decker502/arducuber/assets/6575.png

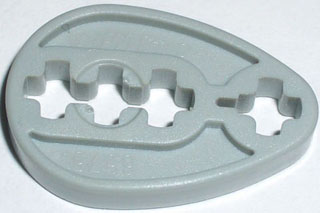
assets/6575.png
