decker502/arducuber/assets/18654.png

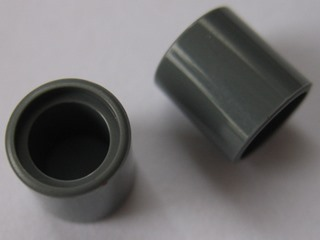
assets/18654.png
