decker502/arducuber/assets/22961.png

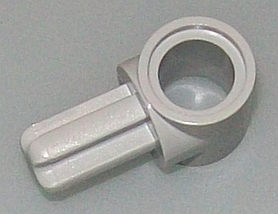
assets/22961.png
