decker502/arducuber/assets/60483.png

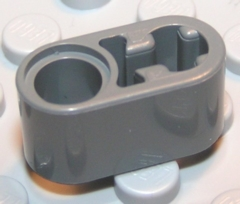
assets/60483.png
