decker502/arducuber/assets/tcs34725.png

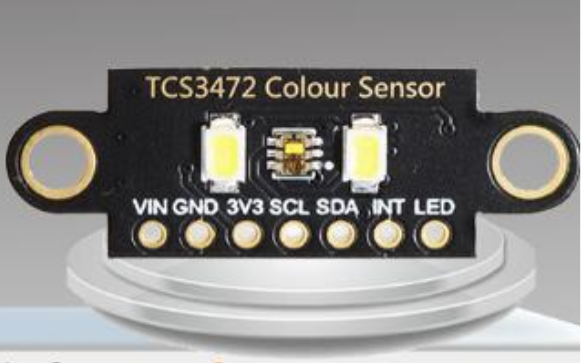
assets/tcs34725.png
