decker502/arducuber/kit/bricktronics_megashield-schematic-v1.01.png

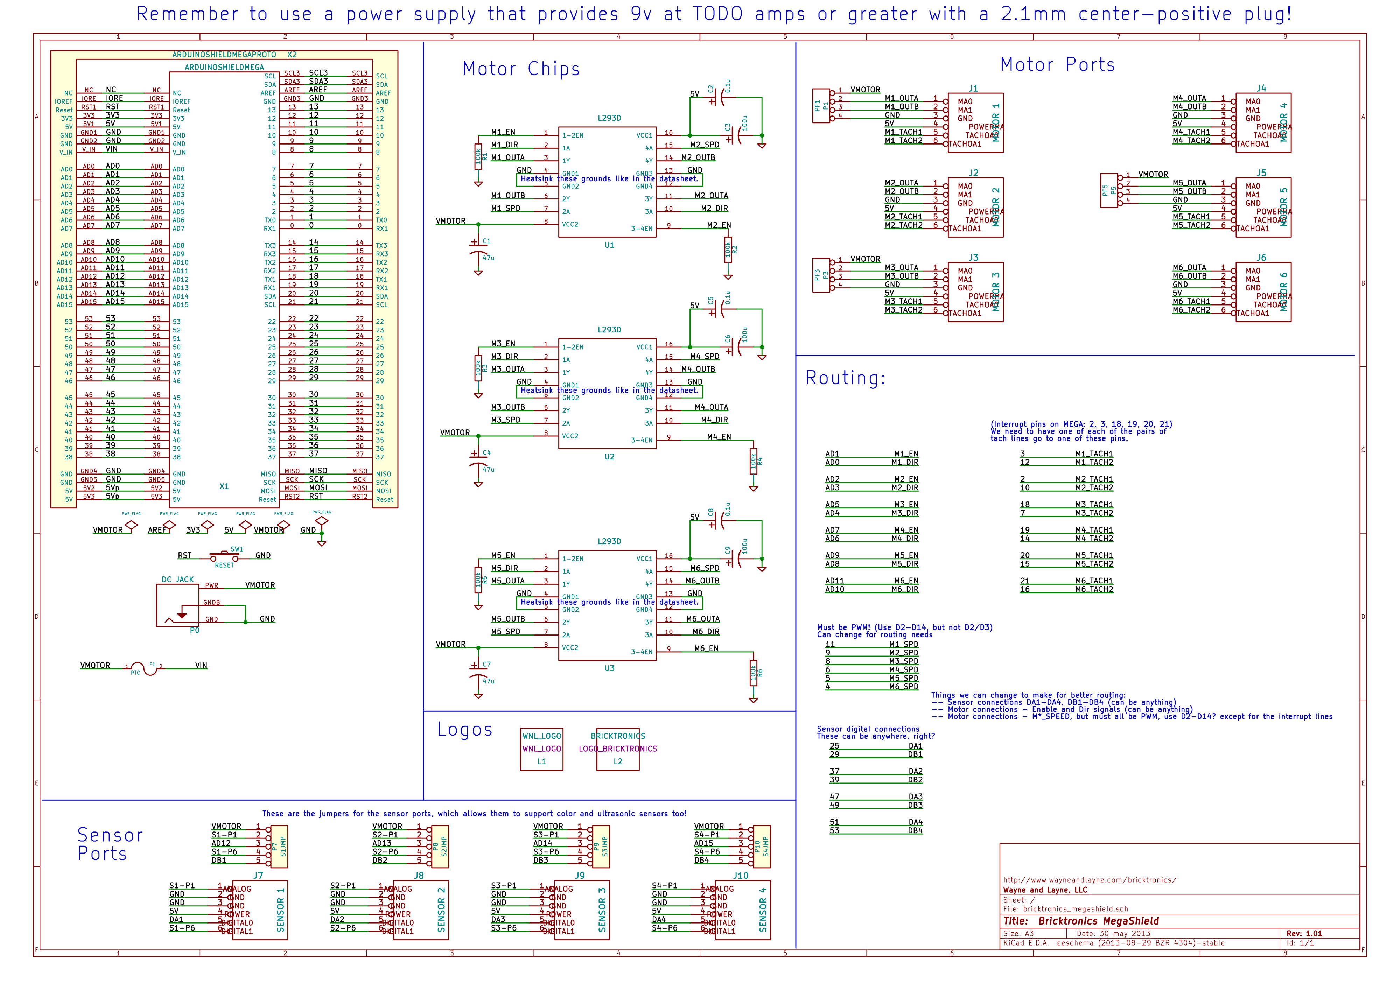
kit/bricktronics_megashield-schematic-v1.01.png
