decker502/arducuber/mcmoves.h

#ifndef MCMOVES_H
#define MCMOVES_H
/*
 * Title               : MindCuber Move Tables
 *
 * Author              : David Gilday
 *
 * Copyright           : (C) 2011-2013 David Gilday
 *
 * Website             : http://mindcuber.com
 *
 * Release Information : v2.2
 *
 * Modified            : $Date: 2013-06-22 11:44:32 +0100 (Sat, 22 Jun 2013) $
 *
 * Revision            : $Revision: 6387 $
 *
 * Usage:
 *
 *   This software may be used for any non-commercial purpose providing
 *   that the original author is acknowledged.
 *
 * Disclaimer:
 *
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
 *-----------------------------------------------------------------------------
 * Purpose : Move tables for MindCuber
 *-----------------------------------------------------------------------------
 */

const int mtb0 = 3;
const byte mtd0[] PROGMEM = {
  0x0C, 0x33, 0xF5,
  0x0E, 0xFF, 0xFF,
  0x03, 0x53, 0xFF,
  0x03, 0x55, 0xFF,
  0x09, 0xF9, 0xFF,
  0x06, 0x88, 0xFF,
  0x0C, 0xFF, 0xFF,
  0x03, 0x54, 0xFF,
  0x11, 0x35, 0xF3,
  0x0A, 0xF9, 0xFF,
  0x06, 0x86, 0xFF,
  0x05, 0x33, 0xFF,
  0x04, 0x4B, 0xFF,
  0x0D, 0xFF, 0xFF,
  0x02, 0x98, 0xFF,
  0x02, 0xFA, 0xFF,
  0x03, 0x5B, 0xFF,
  0x01, 0xFA, 0xFF,
  0x00, 0x98, 0xFF,
  0x00, 0xFA, 0xFF,
  0x0B, 0xF9, 0xFF,
  0x08, 0x6E, 0xF5,
  0x06, 0x96, 0xF3,
  0x08, 0xEE, 0xF5,
  0x03, 0x6C, 0xFF,
  0x08, 0x5E, 0xFF,
  0x09, 0x96, 0xF3,
  0x0B, 0xE8, 0xF5,
  0x06, 0x39, 0xFF,
  0x08, 0x8E, 0xF5,
  0x08, 0x9E, 0x59,
  0x08, 0x7E, 0xF5,
  0x09, 0xE8, 0xF5,
  0x05, 0xB4, 0xF8,
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
  0x09, 0x80, 0x0E, 0x96, 0xBB, 0x81, 0xC0, 0xFF,
  0x05, 0x3E, 0x21, 0xE2, 0xD5, 0x03, 0x3D, 0xFF,
  0x03, 0x09, 0x2B, 0xE1, 0xC2, 0x00, 0xFF, 0xFF,
  0x05, 0xB8, 0x11, 0x11, 0x11, 0x99, 0xF3, 0xFF,
  0x09, 0x80, 0x8E, 0x67, 0xC6, 0x72, 0x61, 0xFF,
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
};

// END

#endif
