decker502/arducuber/fakedata.h

#ifndef FAKEDATA_H
#define FAKEDATA_H

uint8_t fake_rgb[][3] = {
    {246, 88, 76},
    {76, 152, 90},
    {255, 101, 84},
    {89, 54, 55},
    {87, 53, 55},
    {249, 246, 125},
    {86, 52, 53},
    {71, 144, 87},
    {255, 137, 111},
    {45, 60, 76},
    {255, 103, 86},
    {70, 143, 85},
    {91, 54, 55},
    {241, 238, 121},
    {90, 54, 56},
    {170, 168, 177},
    {76, 156, 93},
    {255, 255, 167},
    {255, 98, 82},
    {51, 63, 82},
    {255, 101, 84},
    {255, 102, 85},
    {91, 54, 55},
    {207, 206, 218},
    {86, 53, 54},
    {45, 61, 79},
    {121, 63, 67},
    {78, 163, 95},
    {255, 115, 94},
    {45, 59, 75},
    {255, 99, 83},
    {184, 182, 193},
    {93, 54, 56},
    {255, 253, 128},
    {47, 65, 87},
    {255, 255, 255},
    {72, 147, 87},
    {224, 223, 116},
    {205, 203, 108},
    {186, 184, 195},
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
};

// 扫描完后的色块排列
// U CUBE_DOWN L R F B 代表上下左右前后

// nxt
//
// Face:offset  piece
// 3U:2         8 2 3 4 5 6 7 0 1
// 2R:2         8 2 3 4 5 6 7 0 1
// 1D:2         8 2 3 4 5 6 7 0 1
// 0L:2         8 2 3 4 5 6 7 0 1
// 4B:6         8 6 7 0 1 2 3 4 5
// 5F:2         8 2 3 4 5 6 7 0 1
//
// 扫描前
//       +--5B-+
//       |2 3 4|
//       |1 8 5|
//       |0 7 6|
// +--0L-+--3U-+--2R-+
// |6 7 0|6 7 0|6 7 0|
// |5 8 1|5 8 1|5 8 1|
// |4 3 2|4 3 2|4 3 2|
// +-----+--4F-+-----+
//       |2 3 4|
//       |1 8 5|
//       |0 7 6|
//       +--1D-+
//       |2 3 4|
//       |1 8 5|
//       |0 7 6|
//       +-----+
// 扫描后
//       +--3B-+
//       |2 3 4|
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

#endif
