decker502/arducuber/tilt.h

#ifndef TILT_H
#define TILT_H

#include "global.h"
#include "motor.h"

#define TILT_POWER 80

void TiltAway()
{
    // if (20 < getPosition(M_TILT))
    // {
    //     moveAbs(M_TILT, 60, 20);
    // }

    moveAbs(M_TILT, 60, 10);
}

void TiltCal()
{
    // moveRel(M_TILT, 40, 10);
    endstop(M_TILT, -40);

    reset(M_TILT);

    brake(M_TILT);
    // TiltAway();
}

void TiltHold(bool wait = true)
{
    moveAbs(M_TILT, 50, 97, wait);
}

void Tilt(int n = 1)
{
    TiltHold();

    for (int i = 0; i < n; i++)
    {
        // 使用原参数时，底座横轴与主横梁平行时，底座会发生倾斜式跳动，导致魔方会翻转过头
        // 参见 readme 中 转盘的改造说明
        moveAbs(M_TILT, TILT_POWER, 165);
        delay(50);
        moveAbs(M_TILT, TILT_POWER, 80);
        TiltHold(false);
        delay(50);
    }
}

#endif
