decker502/arducuber/(commit log)

2021-11-11 能稳定识别并还原3类魔方
2021-11-19 提高颜色识别准确率和速度
2021-11-25 还原算法采用mindcuber nxt版本
2021-12-23 三种魔方测试通过
2021-12-23 整理代码
2021-12-23 调整ram使用
2021-12-26 keypad 换为 ADKeyboard 参数
2021-12-28 优化稳定性
2022-01-01 1.修改项目名 2.优化翻转臂稳定性
2022-02-24 fix: 修正改造Button传感器的跳线描述
